andy-glaus-sf/card-track/end_stop.scad

include <params.scad>

// ── Track end stops ───────────────────────────────────────────────────────────
// Two variants are produced here side by side — print one of each.
//
//   End stop A (left)  — SOCKET type — fits the +Y TAB end of a straight section.
//                        The track's +Y tabs click into the stop's sockets.
//
//   End stop B (right) — TAB type   — fits the -Y SOCKET end of a straight section.
//                        The stop's tabs click into the track's -Y sockets.
//
// The barrier wall is high enough to catch the cart body (24 mm above the track
// floor) and prevent it rolling off the end.

// track_total_w now defined in params.scad
barrier_wall_t = 5;
stop_len       = conn_pad_len + barrier_wall_t + 4;  // 32 mm — connector pad + barrier + clearance
barrier_h      = cart_body_h + 6;                    // 28 mm — above cart body top

// ── 2D puzzle profiles ────────────────────────────────────────────────────────
module puzzle_tab_2d() {
    translate([-tab_neck_w / 2, 0])
        square([tab_neck_w, tab_neck_l]);
    translate([0, tab_neck_l])
        circle(d = tab_knob_d, $fn = 64);
}
module puzzle_socket_2d() {
    translate([-(tab_neck_w + tab_clr) / 2, 0])
        square([tab_neck_w + tab_clr, tab_neck_l + tab_clr / 2]);
    translate([0, tab_neck_l])
        circle(d = tab_knob_d + tab_clr, $fn = 64);
}

// ── Shared body: full floor + barrier wall ────────────────────────────────────
module stop_body() {
    union() {
        // Full-width floor
        cube([track_total_w, stop_len, track_floor_t]);
        // Barrier wall at +Y end — blocks the cart from rolling out
        translate([0, stop_len - barrier_wall_t, 0])
            cube([track_total_w, barrier_wall_t, barrier_h]);
    }
}

// ── Socket through-hole in floor at -Y face (socket-type stop) ────────────────
module socket_cuts() {
    translate([bot_conn_x, 0, -0.1])
        linear_extrude(height = track_floor_t + 0.2)
            puzzle_socket_2d();
}

// ── Tab at +Y face: protrudes beyond end face, spans full floor thickness ──────
module tab_protrusions() {
    translate([bot_conn_x, stop_len, 0])
        linear_extrude(height = track_floor_t)
            puzzle_tab_2d();
}

// ── End stop A — SOCKET type (fits +Y tab end of straight section) ────────────
module end_stop_socket() {
    difference() {
        stop_body();
        socket_cuts();
    }
}

// ── End stop B — TAB type (fits -Y socket end of straight section) ────────────
module end_stop_tab() {
    union() {
        stop_body();
        tab_protrusions();
    }
}

// ── Render both side by side (10 mm gap) ─────────────────────────────────────
end_stop_socket();

translate([track_total_w + 10, 0, 0])
    end_stop_tab();
