andy-glaus-sf/card-track/(commit log)

2026-10-23 Add OpenSCAD files for modular card track system
    Parametric 3D-printable track system for passing cards along a table.
    Uses 608ZZ skateboard bearings and M8 bolt axles.
    [cart.scad, params.scad, track_corner.scad, track_straight.scad]
2026-10-23 Redesign cart with friction-fit stub-axle posts for 608ZZ bearings
    Replace bearing-pocket/bolt-axle design with 4 outward-pointing stub-axle
    posts. Bearings press onto posts (8.2 mm post, 8 mm bore). Bearing outer
    race rolls on track floor. Circular relief pocket on each post base prevents
    outer race from rubbing the body during spin.
    [cart.scad, params.scad]
2026-10-23 Narrow cart body to 50 mm, track to 76 mm inner width
    Cart body reduced from 124 mm to 50 mm. Posts (10 mm each side) bring
    total rolling width to 70 mm, fitting in the new 76 mm channel with
    3 mm clearance each side. Top plate remains 200 × 200 mm unchanged.
    Track straight and corner sections recalculate automatically from params.
    [params.scad]
2026-10-23 Replace small pegs with large external connector pads on track sections
    Remove 5 mm pegs from the channel floor. Replace with external connector
    pads (20 × 20 × 15 mm) mounted outside each wall so the cart channel is
    never obstructed. Each pad carries a 14 mm diameter boss (10 mm protrusion)
    on the boss end and a 15 mm socket (0.5 mm clearance per side, 11 mm deep)
    on the socket end. Two connectors per joint for stability. Updated both
    straight and corner sections.
    [params.scad, track_corner.scad, track_straight.scad]
2026-10-23 Replace cylinder connectors with interlocking puzzle-piece tabs
    Each track end now uses a jigsaw-style connector: a rectangular neck
    (12 mm wide × 8 mm long) leading to a round knob (22 mm diameter),
    extruded the full pad height (28 mm). The wider knob locks the joint
    against pull-out. Matching socket adds 1.0 mm total clearance (0.5 mm
    per side). Two connectors per joint (one per wall pad). Updated both
    straight and corner sections; all dimensions driven from params.scad.
    [params.scad, track_corner.scad, track_straight.scad]
2026-10-23 Move track connectors to bottom underside of track
    Removes external side pads. Both outer walls now extend bot_ext (14 mm)
    below the floor face; connector pads fill the gap between them at each end.
    Puzzle tabs protrude from the bottom of the +Y end face; matching sockets
    are cut into the bottom of the -Y end face. Corner entry/exit connectors
    follow the same pattern with swept wall extensions.
    Track rests on the extended wall bottoms — no rocking from connector pads.
    Cart channel is completely clear of connector geometry.
    [params.scad, track_corner.scad, track_straight.scad]
2026-10-23 Split cart into printable bottom and top pieces; trim body 4 mm
    - cart_body_h reduced 26 → 22 mm (4 mm removed from bottom)
    - cart_bottom.scad: body + stub-axle posts + 4 alignment pegs on top face
    - cart_top.scad: 200×200 plate with 4 through-holes matching peg positions
    - cart.scad: assembled visualisation of both pieces
    - Peg: 4 mm dia × 7 mm tall; hole: 4.3 mm dia through-hole (0.3 mm clearance)
    - Pegs protrude ~3 mm above plate top for grip while glue cures
    - plate_t increased 3 → 4 mm for peg engagement depth
    [cart.scad, cart_bottom.scad, cart_top.scad, params.scad]
2026-10-23 Reduce track profile, open floor, and hollow cart body
    Track:
    - track_wall_h 32 → 11 mm (low-profile walls)
    - bot_ext 14 → 3 mm (minimal underside connector nub)
    - Floor now open in the middle of each section; only present at:
    (a) full-width end sections (conn_pad_len deep) for connector backing
    (b) two 9 mm bearing-contact rails running the full length / full arc
    - Corner floor treatment matches: swept bearing-arc rails + end arc floors
    Cart:
    - cart_wall_t = 7 mm introduced; body is now hollow top-to-bottom (no base, no lid)
    - Alignment peg positions updated to mid-wall (21.5 × 66.5 mm), centred in
    the solid wall zones with clearance from the hollow on both sides
    Co-Authored-By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
    [cart.scad, cart_bottom.scad, cart_top.scad, params.scad, track_corner.scad, track_straight.scad]
2026-10-23 Add end_stop.scad with socket and tab variants
    Two end stops rendered side by side in one file — print one of each:
    - End stop A (socket): connects to the +Y tab end of a straight section
    - End stop B (tab): connects to the -Y socket end of a straight section
    Both share the same body (two walls + full floor + barrier wall).
    Barrier height = cart_body_h + 6 = 28 mm, which clears the cart body top
    (24 mm above track floor) and prevents the cart rolling off the end.
    Stop length = 32 mm (conn_pad_len + barrier wall + 4 mm clearance).
    [end_stop.scad]
2026-10-24 Move track connectors from below-floor pads into the floor itself
    Eliminates the 3 mm below-floor extension (bot_ext) from all track pieces.
    Connectors are now flush with the track bottom face (Z=0):
    - Tabs extrude upward from Z=0 through the full floor thickness (track_floor_t)
    - Sockets are through-holes in the end-section floor (open bottom and top)
    Both features print without supports when the track lies flat on the bed.
    Removes separate connector-pad geometry from straight, corner, and end-stop
    pieces; the end-section floor provides the needed material directly.
    [end_stop.scad, params.scad, track_corner.scad, track_straight.scad]
2026-10-26 Replace single U-channel with twin bearing groove rails
    Each 608ZZ bearing now rides in its own narrow U-channel (8 mm inner width,
    3.5 mm walls, 6 mm wall height) instead of rolling on a flat strip inside a
    wide containment channel. The groove walls provide lateral constraint so no
    outer containment walls are needed. Track width reduces from 86 mm to 72 mm.
    - params.scad: remove track_inner_w/wall_h/wall_t/bear_rail_w; add
    rail_ch_w/wall_t/wall_h; derive bear_cx_L/R and track_total_w from
    cart geometry; update connector quarter-points to new width
    - track_straight.scad: replace track_body() with bearing_groove() module
    producing two U-channel rails + full-width end floor bridges
    -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
    [end_stop.scad, params.scad, track_corner.scad, track_straight.scad]
2026-10-26 Redesign track as two rails connected by gap-spanning end bridges
    The track section now clearly reads as two parallel groove rails joined
    only at their ends — an H-shape from above — rather than a wide floor slab
    with two grooves in it.
    - End cross-bridges now span only the gap between the two rail inner faces
    (gap_inner_L to gap_inner_R), not the full track width. Connector pads
    sit at 1/3 and 2/3 of the gap so they land inside open air, clear of both
    rail bodies.
    - Fixed bearing-centre positions: previous formula used bearing_w/2 as the
    offset from the cart body face, missing the 1.5 mm stub axle shoulder gap.
    Correct formula: cart_body_w + 2*(post_shoulder + bearing_w/2)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
    [params.scad, track_corner.scad, track_straight.scad]
2026-10-26 Fix forward-reference bug: move cart_body_w before rail calculations
    bear_cx_R referenced cart_body_w which was defined 40 lines later in the
    file. OpenSCAD does not guarantee forward variable references resolve
    correctly, causing the right rail to collapse onto the left (both grooves
    rendered as one) and the cross-bridges to have zero or negative width.
    cart_body_w is now defined at the top of the file before the bearing
    centre / gap calculations that depend on it. Duplicate definition in
    the Cart section replaced with a comment.
    [params.scad]
2026-10-26 Replace dual mushroom connectors with single round tab
    All four track files now use one centered circular connector
    (circle d=22mm) instead of two mushroom-shaped tabs. params.scad
    replaces bot_conn_x1/bot_conn_x2 with a single bot_conn_x centered
    at track_total_w/2. track_straight, track_corner, and end_stop all
    updated to match.
    [end_stop.scad, params.scad, track_corner.scad, track_straight.scad]
2026-10-26 Change top plate peg holes from through-holes to blind holes
    Blind holes open from the bottom face only (3.2 mm deep, leaving 0.8 mm
    skin at the top). Peg height reduced from 7 mm to 3 mm so pegs sit fully
    inside the plate without protruding above its top surface.
    [cart.scad, cart_bottom.scad, cart_top.scad, params.scad]
2026-10-26 Add shoulder collar to stub axles to stop bearings at correct depth
    Each post now has a 14 mm diameter collar (post_shoulder = 1.5 mm long)
    at its base. The bearing inner race presses against the collar and stops
    1.5 mm clear of the cart body face, preventing the outer race from
    rubbing the body wall.
    [cart.scad, cart_bottom.scad, params.scad]
2026-10-26 Restore interlocking mushroom puzzle profile on all connectors
    Replace plain circle tabs/sockets with neck+knob mushroom shape.
    The knob (22 mm) is wider than the neck (12 mm) — once the knob is
    past the socket neck it cannot pull back through, locking the tracks
    together. Assembly: drop knob through socket knob-hole, slide track
    so knob seats behind the neck.
    [end_stop.scad, track_corner.scad, track_straight.scad]
2026-10-26 Add dice cage that snaps onto cart top plate
    Open-top box (207 × 207 mm outer, 25 mm tall walls) with four integral
    snap clips. Each clip arm (2 mm thick, 4.5 mm long) hangs below the
    cage wall bottom and carries a chamfered wedge hook that rides over the
    plate edge on press-fit and catches 1.5 mm under the plate bottom face.
    Print upside-down so hooks rest on the bed fully supported.
    [dice_cage.scad]
